Taller-de-diseno-digital-GR01/Proyecto-1-Whack-a-mole/docs/Diseños_Separados/diagrama_lvl_3.md

```mermaid
graph LR
    A--> B

subgraph Circuito DIscreto
    Reloj_555[CLK]
    Numeros_aleatorio[LSF] 

end
```
