Taller-de-diseno-digital-GR01/Proyecto-1-Whack-a-mole/docs/Informe.md

# Informe técnico  — Proyecto 1: Whack-a-mole

EL3313 Taller de Diseño Digital, II Semestre 2026

Grupo 1 - Integrantes:
- Jefferson Chinchilla
- Nicolás Mena
- Mattio Coghi
- Carlos Castro

## 1. Fundamentos Teóricos (Investigación previa)

Esta sección desarrolla los doce temas de investigación previa exigidos por el enunciado del
proyecto, conectando cada concepto con la parte del diseño de este *whack-a-mole* híbrido
(protoboard 74xx + FPGA) donde se aplica dichos conceptos.

### 1.1 Modelado de comportamiento y de estructura en diseño digital

En HDL (Hardware Description Language) existen dos formas complementarias de describir un
circuito. El **modelado estructural** describe el circuito como una interconexión de componentes
más simples ya definidos (instancias de módulos, compuertas), de forma análoga a un esquemático:
se declara *qué* bloques existen y *cómo* se conectan sus puertos, pero no *cómo* calculan su
salida. El **modelado de comportamiento** (o *behavioral*), en cambio, describe la función que debe
cumplir el bloque en términos de su comportamiento observable ante los estímulos de entrada —
asignaciones dentro de bloques `always`/`always_comb`/`always_ff`, expresiones aritméticas y
lógicas, sentencias condicionales — dejando que la herramienta de síntesis infiera la red de
compuertas y biestables que lo implementa.

En este proyecto ambos estilos conviven. `top.sv` es predominantemente **estructural**: instancia
y conecta los módulos `fsm`, `time_logic`, `press_btn`, `hit_counter`, `fail_counter`,
`show_mole`, `marcador`, `r_uart` y `state`, sin describir lógica propia más allá del cableado.
Cada uno de esos módulos hijos, en cambio, se describe de forma **conductual**: por ejemplo
`fsm.sv` (`docs/../src/design/fsm.sv`) define el comportamiento de la máquina de estados mediante
un `case` sobre la variable `state` dentro de un `always_comb`, sin indicar explícitamente qué
compuertas resultan de ello. El subsistema discreto en protoboard, por el contrario, solo puede
describirse de forma estructural en el sentido físico: cada 74xx es un componente ya fabricado
cuya interconexión (y no su contenido interno) es lo que el grupo diseña.

### 1.2 Síntesis lógica en ASIC y en FPGA

La síntesis lógica es el proceso automatizado que traduce una descripción en HDL (típicamente a
nivel RTL — *Register Transfer Level*) a una **netlist**: una lista de compuertas y biestables
interconectados que implementa el comportamiento descrito. El flujo pasa por: (1) análisis y
elaboración del HDL, (2) optimización lógica independiente de tecnología (simplificación booleana,
eliminación de lógica redundante), y (3) *technology mapping*, donde esas ecuaciones booleanas se
traducen a los elementos que realmente existen en la tecnología destino.

La diferencia clave entre ambos flujos está en ese último paso. En un **ASIC**, el *mapping* elige
compuertas de una librería de celdas estándar (`AND2`, `NAND3`, `DFF`, etc.) caracterizadas
eléctricamente para un proceso de fabricación específico; el resultado es un layout físico
custom que se manda a fabricar, sin posibilidad de corrección tras la fabricación. En una
**FPGA**, el *mapping* no genera compuertas nuevas: reparte la lógica entre los recursos
programables que el chip ya trae de fábrica (LUTs, biestables, bloques de memoria, DSPs) y genera
además la configuración de las interconexiones programables entre ellos. Por eso el flujo FPGA
agrega dos pasos que el flujo ASIC no tiene de la misma forma: **place & route** (ubicar cada
elemento lógico en una celda física del arreglo y trazar las rutas entre ellas usando la matriz de
conmutación) y la generación de un **bitstream**, el archivo binario que configura las celdas de
memoria SRAM de la FPGA en cada encendido. En este proyecto, ese flujo (síntesis → *place &
route* → *bitstream*) es exactamente el que ejecuta `make bitstream` sobre la tarjeta Basys3
(ver `src/fpga/build_bitstream.tcl`).

### 1.3 Tecnología de FPGAs

Una FPGA (*Field-Programmable Gate Array*) es un circuito integrado cuya función lógica se
configura después de fabricado, en el campo, en vez de quedar fija en el silicio. Su arquitectura
típica es una matriz de **bloques lógicos configurables** (CLB, *Configurable Logic Block*)
embebidos en una red de interconexión programable:

- **LUT (*Look-Up Table*)**: una memoria SRAM pequeña de 2^K bits que implementa cualquier función
  booleana de K entradas simplemente almacenando, en cada dirección, el valor de salida
  correspondiente a esa combinación de entradas. Es el elemento combinacional universal de la
  FPGA — reemplaza a las compuertas individuales de un ASIC.
- **Biestables (flip-flops)**: uno o más por *slice*, disponibles para registrar la salida de la
  LUT y así construir lógica secuencial sin usar recursos combinacionales adicionales.
- **Multiplexores de configuración**: seleccionan, entre varias opciones cableadas físicamente, cuál
  usa el diseño actual (por ejemplo, si la salida de una LUT pasa o no por el biestable).
- **Matriz de conmutación (*switch matrix*) e interconexión programable**: red de buses y
  interruptores configurables que conectan la salida de un CLB con la entrada de otro,
  permitiendo que un mismo arreglo físico implemente topologías de circuito arbitrarias.
- **Bloques dedicados**: bloques de memoria (BRAM), multiplicadores/DSP y buffers de reloj
  globales (BUFG) que aceleran funciones comunes sin gastar LUTs.

Toda esta configuración —el contenido de cada LUT y el estado de cada interruptor de la matriz de
conmutación— se almacena en celdas SRAM que se cargan desde el bitstream en cada encendido; por
eso una FPGA "olvida" su configuración al apagarse y debe reprogramarse, a diferencia de un ASIC.
La Basys3 usada en este proyecto integra una FPGA Xilinx Artix-7, que sigue esta misma
arquitectura de CLBs de dos *slices*, LUTs de 6 entradas y una red de interconexión jerárquica.

### 1.4 Máquinas de estado finito: Moore vs. Mealy

Una máquina de estados finitos (FSM) es un modelo secuencial cuyo comportamiento depende tanto de
las entradas actuales como de un **estado interno**, almacenado en biestables, que resume la
historia relevante de entradas pasadas. En cada flanco de reloj la FSM evalúa una función de
**siguiente estado** a partir del estado actual y las entradas, y produce salidas mediante una
función de **salida**.

La diferencia entre los dos modelos clásicos está exactamente en esa función de salida:

- **Máquina de Moore**: la salida depende **únicamente del estado actual**, `salida = f(estado)`.
  Esto implica que la salida solo puede cambiar en un flanco de reloj (cuando cambia el estado), lo
  que la hace más lenta en reaccionar a un cambio de entrada, pero elimina el riesgo de generar
  glitches combinacionales en la salida y facilita el análisis de tiempos, porque la salida no
  depende de una ruta combinacional que incluya entradas externas.
- **Máquina de Mealy**: la salida depende **del estado actual y de las entradas presentes**,
  `salida = f(estado, entradas)`. Puede reaccionar en el mismo ciclo en que cambia una entrada
  (una transición completa antes), lo que en general produce máquinas con menos estados para el
  mismo comportamiento, pero la salida puede generar glitches si la entrada cambia de forma
  asíncrona respecto al resto del sistema.

La FSM central de este proyecto (`fsm.sv`) es de tipo **Moore**: dentro del bloque
`always_comb`, todas las señales de salida (`en_numRandom`, `en_save_pos`, `add_hit`,
`add_failure`, `rst_window`, `f_state_play`, `f_state_gameover`, etc.) se asignan según un `case
(state)` que solo examina la variable de estado, nunca directamente las entradas `valid_pos`,
`hit` o `window_exp` dentro de la misma rama de asignación de salida — esas entradas solo se usan
para decidir `next_state`. Esto es deliberado: como la salida `en_numRandom` habilita al
subsistema discreto y las salidas de conteo (`add_hit`, `add_failure`) alimentan contadores
síncronos, se prefiere que permanezcan estables durante todo un estado y cambien solo en los
flancos de reloj, evitando pulsos espurios de habilitación si `hit` o `miss` tuvieran un glitch
combinacional aguas arriba.

**Diagrama de estados (Moore) — señales de salida asociadas a cada estado, no a las transiciones:**

```mermaid
stateDiagram-v2
    [*] --> START
    START --> REQ_POS: rst_dificulty/rst_hits/rst_failures/rst_window = 1
    REQ_POS --> WAIT_UART: en_numRandom = 1
    WAIT_UART --> PLAY: valid_pos (en_numRandom, en_save_pos = 1)
    PLAY --> HIT: hit (f_state_play = 1)
    PLAY --> FAILURE: miss OR window_exp (f_state_play = 1)
    HIT --> REQ_POS: add_hit, inc_dificulty, rst_window = 1
    FAILURE --> REQ_POS: !cont_failure (add_failure, rst_window = 1)
    FAILURE --> GAME_OVER: cont_failure (add_failure, rst_window = 1)
    GAME_OVER --> START: fin_espera (f_state_gameover = 1)
```

Nótese que, en la notación Moore estándar, las etiquetas sobre las flechas son solo condiciones de
transición (entradas), mientras que las salidas —escritas aquí entre paréntesis junto a cada
estado— pertenecen al estado en sí y se mantienen fijas mientras la FSM permanece en él. En una
FSM de Mealy equivalente, salidas como `add_hit` aparecerían directamente sobre la transición
`PLAY → HIT`, es decir, se activarían en el mismo ciclo en que `hit` se vuelve verdadera en vez de
esperar al estado siguiente.

### 1.5 Tiempo de *setup* y tiempo de *hold*

Todo biestable disparado por flanco tiene una ventana de tiempo alrededor del flanco de reloj
activo durante la cual su entrada de datos `D` debe permanecer **estable** para garantizar que la
salida `Q` capture correctamente el valor:

- **Tiempo de *setup* ($t_{su}$)**: intervalo mínimo que `D` debe mantenerse estable **antes** del
  flanco de reloj.
- **Tiempo de *hold* ($t_h$)**: intervalo mínimo que `D` debe mantenerse estable **después** del
  flanco de reloj.

Si alguno de los dos se viola, la salida del biestable puede entrar en un estado **metaestable**:
un nivel de tensión intermedio, indefinido lógicamente, que eventualmente colapsa hacia `0` o `1`
de forma impredecible y en un tiempo variable, en vez de asentarse de inmediato en el valor
esperado. Estas cotas son las que acotan, en un diseño síncrono, cuánto puede demorar la lógica
combinacional entre dos biestables (violación de *setup*, "camino largo") y cuánto puede demorar
como mínimo (violación de *hold*, "camino corto"). Por eso son centrales para el diseño digital:
determinan la frecuencia máxima de operación confiable de un circuito síncrono y, en el caso del
*hold*, incluso pueden causar fallas independientes de la frecuencia de reloj, ya que un camino
demasiado corto entre dos registros viola *hold* sin importar qué tan lento se reloje el sistema.
En este proyecto, estas cotas las garantiza automáticamente la herramienta de *place & route* de
la FPGA (análisis estático de tiempos) para toda la lógica interna a 100 MHz; el diseño del
subsistema discreto en protoboard, en cambio, no cuenta con esa verificación automática, por lo
que las frecuencias de trabajo (9600 baudios) se eligen con margen suficiente para que estas
restricciones nunca se acerquen a ser críticas.

### 1.6 Tiempos de propagación y de contaminación, ruta crítica

En un bloque combinacional, la salida no cambia instantáneamente cuando cambia la entrada:

- **Tiempo de propagación ($t_{pd}$)**: el tiempo **máximo** que tarda la salida en alcanzar su
  valor final y estable tras un cambio en la entrada.
- **Tiempo de contaminación ($t_{cd}$)**: el tiempo **mínimo** que la salida tarda en empezar a
  cambiar (dejar de ser válida) tras un cambio en la entrada.

Entre dos biestables consecutivos, unidos por lógica combinacional, estos tiempos se combinan con
$t_{su}$ y $t_h$ del biestable destino para dar las dos condiciones que el diseño debe cumplir:

$$T_{clk} \geq t_{pcq} + t_{pd} + t_{su} \qquad\qquad t_{ccq} + t_{cd} \geq t_h$$

donde $t_{pcq}$/$t_{ccq}$ son los tiempos de propagación/contaminación del propio flip-flop
origen (reloj → Q). La primera desigualdad es la que impone un límite superior a la frecuencia de
reloj: define la **ruta crítica**, el camino combinacional de mayor $t_{pd}$ entre cualquier par
de registros del diseño, y de ahí la **frecuencia máxima de operación**:

$$f_{max} = \frac{1}{t_{pcq} + t_{pd,\text{ruta crítica}} + t_{su}}$$

En sistemas complejos, la ruta crítica no siempre es obvia a priori: puede atravesar varios
niveles de lógica y varios módulos, por lo que las herramientas de síntesis/implementación la
identifican automáticamente mediante análisis estático de tiempos (STA) y reportan el *slack*
(margen) de cada camino. Un diseño con muchos niveles de lógica combinacional entre registros —por
ejemplo, una cadena larga de comparadores o sumadores sin registrar— alarga la ruta crítica y baja
$f_{max}$; segmentar esa lógica con registros intermedios (*pipelining*) es la técnica estándar
para subir la frecuencia máxima a costa de más latencia en ciclos.

### 1.7 Asignación de relojes y entradas habilitadoras (*clock enables*)

El enunciado exige que todo el subsistema FPGA opere con un único reloj de entrada de 100 MHz, pero
distintas partes del sistema deben avanzar a ritmos muy diferentes: la lógica de juego reacciona a
pulsadores en microsegundos, mientras que la ventana de tiempo se cuenta en cientos de milisegundos
y el marcador se refresca a un ritmo perceptible para el ojo humano. La mala práctica para resolver
esto sería generar relojes derivados con divisores libres (contadores cuya salida se usa como reloj
de otro bloque): eso crea dominios de reloj adicionales dentro de la misma FPGA, con todos los
problemas de *skew*, enrutamiento no dedicado y cruce de dominios de reloj (CDC) que ello implica,
además de que la herramienta de síntesis ya no puede cerrar el análisis de tiempos de forma directa
sobre esa señal.

La alternativa recomendada, y la que usa este proyecto, es mantener un **único reloj físico** de
100 MHz para todos los biestables del diseño, y generar en su lugar señales de **clock enable**:
una señal que vale `1` solo durante el ciclo de reloj en que un bloque debe actualizar su estado, y
`0` en el resto, de modo que ese biestable ignore los demás flancos. `time_logic.sv` implementa
exactamente este patrón: un prescalador (`contador_presc`) cuenta ciclos de 100 MHz hasta alcanzar
`N_PRESC` (el equivalente a 100 ms) y en ese ciclo genera un pulso `tick` de un ciclo de duración;
`ventana_ticks` y `contador_ventana` solo se actualizan cuando `tick` vale `1`
(`else if (tick & (contador_ventana != 0)) contador_ventana <= contador_ventana - 1;`), pese a que
sus biestables siguen disparados por el mismo `posedge clk` de 100 MHz que el resto del sistema.
De esta forma toda la FPGA comparte una sola red de reloj (más fácil de cerrar en tiempos y sin
riesgo de metaestabilidad interna), mientras cada bloque avanza a la cadencia que necesita mediante
su propio `enable`.

### 1.8 Rebotes, ruido y metaestabilidad; sincronizador de dos etapas

**Rebotes (*bounce*).** Un pulsador o interruptor mecánico no transiciona limpiamente entre niveles
al presionarse o soltarse: el contacto metálico rebota físicamente varias veces antes de asentarse,
produciendo una ráfaga de transiciones rápidas (típicamente de algunos a varios milisegundos de
duración) donde un sistema digital, muestreando a alta frecuencia, vería múltiples flancos en vez
de uno solo. Las técnicas para cancelarlo se dividen en:

- **Analógicas**: un filtro RC pasabajos en la línea del pulsador, a veces combinado con un
  disparador Schmitt para restaurar flancos limpios, que atenúa las transiciones rápidas del rebote
  dejando pasar solo el cambio de nivel sostenido.
- **Digitales**: un contador o temporizador que solo acepta el nuevo nivel como válido si se
  mantiene estable durante una ventana de tiempo mínima (por ejemplo, unos pocos milisegundos),
  descartando cualquier transición anterior a ese plazo. Es el enfoque de `debounce.sv` en este
  proyecto: un contador de `N=21` bits solo actualiza la salida `db_out` cuando el propio contador
  alcanza su valor máximo (`q_reg[N-1]`) sin que la entrada haya cambiado de estado en el ínterin
  (`q_reset = dff1 ^ dff2` reinicia el contador ante cualquier cambio).

**Metaestabilidad y entradas asíncronas.** Los ocho pulsadores externos y el botón de reinicio son
señales generadas por el jugador, sin ninguna relación de fase con el reloj de 100 MHz de la FPGA:
son **entradas asíncronas**. Si una de estas señales cambia justo dentro de la ventana de *setup*/
*hold* de un biestable interno, ese biestable puede entrar en metaestabilidad (ver §1.5) y, peor
aún, esa salida indefinida puede propagarse de forma distinta a distintos bloques que la consumen
en el mismo ciclo, produciendo inconsistencias internas.

La solución estándar es el **sincronizador de dos etapas** (*double flip-flop synchronizer*): dos
biestables en cascada, ambos gobernados por el reloj del dominio destino, donde solo la salida del
segundo se considera válida para el resto del sistema. El primer biestable es el que puede volverse
metaestable, pero dispone de un ciclo de reloj completo para resolverse hacia `0` o `1` antes de que
el segundo lo muestree; la probabilidad de que la metaestabilidad sobreviva ambas etapas
decrece exponencialmente con el tiempo disponible y se vuelve despreciable para propósitos
prácticos. El costo es una latencia de dos ciclos de reloj entre el cambio real de la entrada y su
valor sincronizado. `debounce.sv` integra esta técnica directamente: `dff1`/`dff2` son exactamente
ese sincronizador de dos etapas (`dff1 <= btn_in; dff2 <= dff1;`), aplicado *antes* de la lógica de
filtrado de rebotes, de modo que un mismo módulo resuelve ambos problemas —asincronía mecánica y
metaestabilidad eléctrica— para cada uno de los ocho pulsadores.

### 1.9 Registro de desplazamiento discreto (serie-paralelo / paralelo-serie)

Un registro de desplazamiento (*shift register*) es una cadena de biestables tipo D conectados en
cascada, donde la salida de cada etapa alimenta la entrada de dato de la siguiente, y todos
comparten la misma línea de reloj. En cada flanco activo, el contenido completo se desplaza una
posición. Con integrados discretos de la familia 74xx existen dos variantes según cómo se accede al
contenido:

- **Serie-a-paralelo (S/P)**: los bits entran uno a uno por una sola línea de dato serie (`SER`), y
  tras N flancos de reloj las N salidas paralelas (`Q0`...`QN-1`) contienen la palabra completa
  recibida. Es la función que necesita un **receptor** serie: reconstruir un dato paralelo a partir
  de bits que llegan uno por uno.
- **Paralelo-a-serie (P/S)**: el registro admite, además del desplazamiento, una **carga paralela**
  síncrona que copia de golpe un valor de N bits (por ejemplo, `74LS165`) a las N etapas; luego,
  conmutando a modo desplazamiento, esos N bits salen uno a uno por una única línea serie en
  flancos de reloj sucesivos. Es la función que necesita un **transmisor** serie: convertir un dato
  ya disponible en paralelo en un flujo de bits secuencial.

En comunicación serial discreta, ambas modalidades trabajan en conjunto en los dos extremos del
enlace: el lado que transmite usa un registro P/S para empaquetar el dato paralelo en una trama
serie, y el lado que recibe usa un registro (o su equivalente descrito en HDL, como en `r_uart.sv`
de este proyecto) para recomponer esos bits seriales en una palabra paralela. El subsistema
discreto de este proyecto usa esta idea en `docs/Diseño.md` (nivel 4, M5): un registro tipo P/S
que carga la posición generada por el LFSR (§1.10) y la desplaza bit a bit hacia la FPGA siguiendo
el reloj de baudios generado por el 555 (M1).

### 1.10 Generación de números pseudoaleatorios con LFSR

Un **LFSR** (*Linear Feedback Shift Register*) es un registro de desplazamiento cuya entrada serie
no viene de una fuente externa, sino de una función XOR (lineal, sobre GF(2)) aplicada a un
subconjunto fijo de sus propias etapas, llamado los *taps*. En cada flanco de reloj el registro se
desplaza y la nueva etapa de entrada toma el valor de esa combinación XOR, de modo que el registro
recorre una secuencia determinista de estados que, sin conocer la estructura de realimentación,
resulta indistinguible de una secuencia aleatoria — de ahí "pseudo"-aleatorio.

**Polinomio de realimentación y período máximo.** Los *taps* se representan formalmente como un
polinomio sobre GF(2), $p(x) = x^n + c_{n-1}x^{n-1} + \dots + c_1 x + 1$, donde cada coeficiente
$c_i=1$ indica que la etapa $i$ participa en la realimentación. Un registro de $n$ etapas tiene
$2^n$ estados posibles, pero el estado *todo ceros* es un punto fijo (la XOR de puros ceros es
cero, así que el registro nunca sale de ahí), por lo que el período máximo alcanzable es
$2^n - 1$. Ese máximo solo se logra si $p(x)$ es un **polinomio primitivo** sobre GF(2); en ese
caso el LFSR se llama de **longitud máxima** y recorre los $2^n-1$ estados no nulos exactamente una
vez antes de repetirse. Para $n=4$, un polinomio primitivo conocido es
$p(x) = x^4 + x + 1$ (taps en las etapas 4 y 1), que da período $2^4-1=15$; el LFSR de este
proyecto usa en cambio los taps en las etapas 3 y 4 ($D_1 = Q_3 \oplus Q_4$, documentado en
`docs/Diseño.md` nivel 4, M3), que corresponde al polinomio equivalente $x^4+x^3+1$, también
primitivo, y produce igualmente el período máximo de 15 estados — verificado de forma explícita en
la tabla de secuencia de ese documento.

**LFSR discreto vs. descrito en HDL.** Con integrados discretos (74LS74 + 74LS86 en este proyecto),
el LFSR es literalmente lo que su nombre indica: una cadena física de flip-flops con una compuerta
XOR de realimentación cableada; los *taps* quedan fijados por el cableado y modificarlos exige
recablear el circuito. Descrito en HDL para una FPGA, el mismo comportamiento se reduce a una
asignación de un par de líneas de código (por ejemplo `lfsr <= {lfsr[2:0], lfsr[3]^lfsr[2]};`), sin
costo de componentes adicionales, y los *taps* se cambian editando una constante y volviendo a
sintetizar — con la ventaja adicional de que la longitud del registro (y por tanto el rango de
valores generados) es trivial de ajustar en HDL, mientras que en discreto implica agregar o quitar
flip-flops físicos.

### 1.11 Decodificador y su uso para seleccionar 1 de N líneas

Un decodificador de $k$ a $2^k$ líneas toma una palabra binaria de $k$ bits y activa exactamente
**una** de sus $2^k$ salidas — la que corresponde numéricamente al valor de esa palabra — dejando
todas las demás inactivas. El **74LS138** es el ejemplo estándar de 3 a 8 líneas: sus salidas
`Y0`...`Y7` son activas en bajo, y cuenta además con tres entradas de habilitación (`E1`, `E2`
activas en bajo, `E3` activa en alto) que deben cumplirse simultáneamente para que el decodificador
opere; si no se cumplen, todas las salidas permanecen inactivas (en alto) sin importar el valor de
las entradas de selección. Este comportamiento equivale, en lógica de dos niveles, a implementar
cada salida $Y_i$ como la AND de las variables de entrada en su forma directa o negada según el
valor de $i$ en binario (un minitérmino), lo que hace del decodificador el bloque natural para
convertir cualquier función booleana en suma de minitérminos, o —como en este proyecto— para
activar un único indicador físico a partir de un código binario.

En el subsistema discreto de este proyecto (`docs/Diseño.md`, M4), el 74LS138 recibe directamente
`pos[2:0]` desde el LFSR y activa el LED correspondiente a la posición del topo, con sus tres
entradas de habilitación fijas al estado activo de forma permanente (el bloque debe estar
habilitado en todo momento) y aprovechando la polaridad activa en bajo de sus salidas para que sea
el propio integrado quien absorba la corriente del LED en vez de entregarla.

### 1.12 Protocolo de comunicación serial asíncrona UART

UART (*Universal Asynchronous Receiver/Transmitter*) es un protocolo de comunicación serial punto a
punto sin línea de reloj compartida entre transmisor y receptor. Cada trama tiene el siguiente
formato:

| Campo | Duración | Función |
|---|---|---|
| Bit de inicio (*start bit*) | 1 bit, siempre en `0` | Marca el comienzo de la trama; su flanco de bajada es la única referencia temporal que el receptor usa |
| Bits de datos | típicamente 5–9 bits, LSB primero | Contienen el dato a transmitir |
| Bit de paridad (opcional) | 0 o 1 bit | Detección simple de errores de un bit |
| Bit(s) de parada (*stop bit*) | 1 o 2 bits, siempre en `1` | Devuelve la línea a su nivel de reposo y da margen antes de la siguiente trama |

Entre tramas, la línea permanece en reposo en nivel alto; el flanco de bajada que marca el inicio
del *start bit* es lo único que el receptor necesita detectar para sincronizarse: a partir de ese
instante, cuenta sus propios intervalos de tiempo (derivados de su propio reloj) del tamaño de un
bit, y muestrea la línea en el centro de cada intervalo sucesivo. El **baud rate** es la cantidad de
símbolos (bits) transmitidos por segundo; ambos extremos deben acordarlo de antemano porque no hay
ninguna señal de reloj física compartida que se lo indique al receptor durante la trama.

Que dos dispositivos sin reloj compartido puedan comunicarse de forma confiable depende de que
ese acuerdo previo de velocidad sea preciso: cada dispositivo genera su reloj de bit de forma
completamente local (en este proyecto, un 100 MHz dividido internamente en la FPGA vs. un
oscilador NE555 discreto en el protoboard), y cualquier diferencia entre esas dos frecuencias
nominalmente iguales hace que el punto de muestreo del receptor se desplace, bit a bit, respecto al
centro real del bit transmitido. Como el receptor solo se resincroniza en cada nuevo *start bit*,
ese desfase se acumula a lo largo de toda la trama y es mayor en el bit más alejado del flanco de
sincronización — el bit de parada. La tolerancia de error de reloj admisible se deriva justamente
de exigir que ese desfase acumulado, en el bit más lejano, sea menor a medio período de bit (para
no cruzar hacia el bit vecino); con una trama 8N1 (1 inicio + 8 datos + 1 parada) ese análisis da
un límite teórico de aproximadamente 1/19 ≈ 5,3 % de error relativo entre los dos relojes (deducido
en detalle en `docs/Diseño.md`, nivel 4, M1), consistente con la práctica de la industria de acotar
el error combinado de los dos extremos de un enlace UART típico a 2–3 % para dejar margen de
diseño. Este proyecto fija su velocidad en 9600 baudios —una tasa estándar, fácil de generar con un
555 dentro de esa tolerancia usando resistencias de precisión al 1 %— precisamente para que ese
margen se cumpla sin necesidad de calibración activa entre los dos dominios de reloj.

---

## Referencias

- [Configurable Logic Block — ScienceDirect Topics](https://www.sciencedirect.com/topics/computer-science/configurable-logic-block)
- [Xilinx Artix-7 architecture — CSE UNL](https://cse.unl.edu/~jfalkinburg/cse_courses/2022/436/lecture/lecture32.html)
- [FPGA Clock Design Scheme: Best Practices — DEV Community](https://dev.to/carolineee/fpga-clock-design-scheme-best-practices-and-implementation-guide-3bke)
- [Mastering Clock Management in Xilinx 7 Series FPGAs — Kite Metric](https://kitemetric.com/blogs/mastering-clock-management-in-xilinx-7-series-fpgas)
- [Linear feedback shift register, 4-bit maximal length — UOBabylon](https://www.uobabylon.edu.iq/eprints/paper_1_17528_649.pdf)
- [Maximum Length Linear Feedback Shift Registers — Peter Fischer, Uni Heidelberg](https://sus.ziti.uni-heidelberg.de/Lehre/WS_DST/LFSR.pdf)
- [Determining Clock Accuracy Requirements for UART Communications — Analog Devices](https://www.analog.com/en/resources/technical-articles/determining-clock-accuracy-requirements-for-uart-communications.html)
- [UART Baud Rate: How Accurate Does It Need to Be? — All About Circuits](https://www.allaboutcircuits.com/technical-articles/the-uart-baud-rate-clock-how-accurate-does-it-need-to-be/)
- [Understanding Digital Circuit Timing: Setup Time, Hold Time, Contamination Delay & Clock Skew — JLCPCB](https://jlcpcb.com/blog/digital-circuit-timing-basics)
- [Lesson 12: Setup and Hold Time — Nandland](https://nandland.com/lesson-12-setup-and-hold-time/)
- [Clock Domain Crossing Techniques & Synchronizers — EDN](https://www.edn.com/synchronizer-techniques-for-multi-clock-domain-socs-fpgas/)

## 2. Presentación de resultados

Todos los módulos SystemVerilog del subsistema FPGA tienen su propio testbench en `src/sim/`,
verificado con `make sim TB=<módulo>` o corriendo el paquete completo con `make test`. Las formas
de onda que acompañan cada módulo se generaron con `make dump TB=<módulo> SIGS=señal1,señal2,...`,
que corre la simulación y exporta un SVG con `vecdump`, una herramienta hecha aparte para este
propósito que lee el `.vcd` producido por `iverilog`/`vvp` y dibuja el diagrama de tiempo
directamente en SVG, sin pasar por una captura de pantalla de GTKWave. El código fuente y los
testbenches completos de cada módulo pueden revisarse en `src/design/` y `src/sim/` respectivamente.

Antes de poder generar estas capturas hubo que corregir varios testbenches que habían quedado
desactualizados respecto a la interfaz actual de los módulos que prueban. El detalle de esos
arreglos, y de las discrepancias reales que sí quedaron pendientes de resolver en el diseño, se
discute en la sección 3.

### 2.1 M1 y M1b, receptor y transmisor UART (`r_uart.sv`, `t_uart.sv`)

`r_uart.sv` recibe una trama serial 8N1 y la traduce a `pos_topo`/`valid_pos`. Su testbench
(`tb_r_uart.sv`) cubre cuatro casos, una trama válida con dato `8'h05`, una trama válida con dato
`8'hFA` (para confirmar que solo los 3 bits bajos se usan como posición), una trama con *stop bit*
inválido (debe descartarse sin activar `valid_pos`), y una trama válida pero con `en_save_pos=0`
(no debe capturar). Los cuatro casos pasan.

Recepción UART, trama válida y trama descartada por stop bit inválido

`t_uart.sv` es el transmisor interno agregado para el enlace en *loopback* (reemplaza al
transmisor discreto, no confiable, para efectos de simular todo el sistema dentro de la FPGA). Su
testbench arma tres tramas (posiciones 5, 2 y 7) y muestrea `tx` en el centro de cada bit para
verificar el formato completo (inicio, 8 datos LSB primero, parada). Los 32 checks (reposo inicial
más 3 tramas de unos 10 bits cada una) pasan.

Transmisión UART interna, tramas para las posiciones 5, 2 y 7

### 2.2 M2, despliegue del topo (`show_mole.sv`)

Módulo puramente combinacional, activa uno de los 8 LEDs según `pos_topo` mientras `en_topo` esté
en alto, y los apaga todos si `en_topo=0`. Su testbench (`tb_show_mole.sv`) no hace *self-checking*
(sigue la convención del equipo de revisar la forma de onda a ojo para módulos puramente
combinacionales), así que no hay PASS/FAIL que reportar, solo la forma de onda para inspección
visual.

Recorrido de las 8 posiciones con en_topo en 0 y en 1

### 2.3 M3, botones (`press_btn.sv`, formado por `debounce` + `encoder_8_to_1` + `check_btn`)

El testbench (`tb_press_btn.sv`) presiona y mantiene un botón, verificando que `valid` se active
exactamente cuando el botón sostenido corresponde a `pos_topo`. Cuatro casos, botón correcto, botón
incorrecto, ningún botón presionado, botón correcto en otra posición. Los cuatro pasan.

Pulso de valid sincronizado con el botón correcto tras el debounce

### 2.4 M4, lógica de tiempo (`time_logic.sv`)

El testbench reduce los parámetros de reloj y ventana a valores pequeños para simular rápido
(`CLK_FREQ_TB=1000`, ventana inicial equivalente a 3 ticks, piso de 1 tick) y verifica, inspeccionando
`ventana_ticks`/`contador_ventana` con `$display`, que sin ningún acierto la ventana expira y activa
`UP`, que cada acierto baja `ventana_ticks` en 1, y que un tercer acierto seguido, ya en el piso, no
lo baja más allá del mínimo.

Ventana de tiempo bajando con cada acierto hasta tocar el piso

### 2.5 M5, contador de aciertos (`hit_counter.sv`)

Verifica el acarreo BCD (unidades a decenas en el décimo acierto), la saturación en 99, y que un
`nueva_partida` o `rst` simultáneo con un `hit` gane sobre el incremento.

Conteo BCD de aciertos, acarreo en el hit 10 y saturación en 99

### 2.6 M6, contador de fallos (`fail_counter.sv`)

Misma lógica de acumulado BCD que M5 pero con `miss`, más la racha de fallos consecutivos
(`consecutivos`) y la bandera `fin_partida` que se activa al tercer fallo seguido. El testbench
confirma que un `hit` intercalado rompe la racha sin bajar el acumulado de `fallo`, y que
`nueva_partida`/`rst` limpian todo incluyendo `fin_partida`.

Racha de fallos consecutivos activando fin_partida, y un hit rompiéndola

### 2.7 M7, estado de juego (`state.sv`)

Cubre los cuatro estados de `(f_state_play, f_state_gameover)`, reposo, partida activa (LED fijo),
combinación inválida (apagado seguro) y fin de partida (parpadeo más `fin_espera` a los 2s reales,
acelerado en el testbench con `N_PRESC=10`). De 13 verificaciones puntuales, 1 falla, el pulso de
`fin_espera` llega un tick de 100ms más tarde de lo que el testbench asume. La causa se discute en
la sección 3, es un hallazgo nuevo porque este testbench no compilaba antes de esta sesión.

Entrada a fin de partida, parpadeo del LED y pulso de fin_espera

### 2.8 M8, máquina de estados central (`fsm.sv`)

Recorre los siete estados (`START, REQ_POS, WAIT_UART, PLAY, FAILURE, HIT, GAME_OVER`), camino
feliz hasta un acierto, un fallo por botón incorrecto, expiración de ventana, prioridad de `hit`
sobre `miss` simultáneos, la racha hasta `GAME_OVER` y el regreso a `START` vía `fin_espera`, y el
reset. Los 9 checks pasan.

Transiciones de la FSM, camino feliz, fallo, y GAME_OVER hasta START

### 2.9 Integración (`top.sv`)

`tb_top.sv` conecta todos los módulos anteriores (incluyendo `r_uart`/`t_uart` en *loopback*
interno, ya que el transmisor discreto real no es confiable) y corre 5 escenarios de principio a
fin, acierto normal, fallo por botón equivocado, tres fallos consecutivos hasta `GAME_OVER` y
reinicio automático, expiración de ventana sin presionar nada, y el multiplexado de los 4 dígitos
del marcador. Las 12 verificaciones pasan, después de corregir el parámetro de time_logic.sv que
se describe en la sección 3 (antes de esa corrección, 3 de las 12 fallaban, las tres por la misma
causa raíz).

Escenario de integración completo, acierto, fallos consecutivos y GAME_OVER

## 3. Análisis e interpretación de resultados

### 3.1 Corrección de la infraestructura de verificación (prerrequisito, no hallazgo de diseño)

Antes de interpretar cualquier resultado hay que poder confiar en la herramienta que lo produce.
Esta sección documenta trabajo de mantenimiento sobre los testbenches en sí, no una observación
sobre el comportamiento del diseño, y por eso se separa de los hallazgos reales de las secciones
3.2 a 3.4.

Antes de poder correr `make test` sin errores de compilación hubo que corregir varios testbenches
que habían quedado detrás de cambios de interfaz en los módulos que prueban, probablemente de
revisiones que ampliaron los puertos de `fsm.sv` y separaron el reset único de `time_logic.sv` en
`rst_dificulty`/`rst_window`, sin que ese cambio se propagara a todos los testbenches ya existentes:

- `tb_show_mole.sv` instanciaba un módulo `m02_show_mole` que no existe (el módulo real se llama
  `show_mole`), no compilaba en absoluto.
- `tb_state.sv` instanciaba `estado_juego`, que tampoco existe (el módulo real se llama `state`),
  tampoco compilaba.
- `tb_time_logic.sv` conectaba un puerto `rst` que ya no existe en `time_logic.sv` (ahora son dos
  puertos separados, `rst_dificulty` y `rst_window`), no compilaba.
- `tb_fsm.sv` usaba conexión implícita (`fsm dut(.*)`) y le faltaba declarar la señal
  `fin_espera`, que la FSM ahora recibe como entrada, tampoco compilaba.
- `press_btn_tb.sv` no seguía la convención de nombres `tb_*.sv`, así que el Makefile ni siquiera lo
  detectaba como testbench disponible, no aparecía en `make list`.
- Una vez corregidos los tres primeros puntos, `press_btn_tb.sv` (ya renombrado a
  `tb_press_btn.sv`) sí compilaba y corría, pero fallaba 2 de 4 casos porque el reset se activa
  (`rst=1`) para el pulso inicial y nunca se vuelve a desactivar, así que el módulo bajo prueba
  queda en reset permanente. Al corregir eso hizo falta además actualizar cómo se verifica `valid`,
  porque el diseño actual la genera como un pulso de un solo ciclo (commit "evita miss fantasma
  tras un hit") y el testbench todavía la muestreaba como si fuera una señal de nivel, tomando su
  valor recién al final de la ventana de espera, momento en el que el pulso ya había pasado.
- `tb_fsm.sv` probaba el reset de la FSM como si fuera asíncrono (`rst=1; #1;` sin esperar el
  flanco de reloj), pero `fsm.sv` lo tiene síncrono desde el commit "trae de develop el fix de
  fsm.sv (en_numRandom sostenido + reset sincrono)".
- `tb_r_uart.sv` y `tb_t_uart.sv` escribían su volcado a `dump.vcd` en vez de
  `tb_r_uart.vcd`/`tb_t_uart.vcd`, y `tb_state.sv` a `estado_juego.vcd` en vez de `tb_state.vcd`,
  así que `make dump` (que asume el nombre `tb_<módulo>.vcd`) no los encontraba.

Ninguno de estos cambios tocó `src/design/`, son correcciones del lado del testbench para que
reflejaran la interfaz y el comportamiento actuales del diseño.

### 3.2 Hallazgo real, corregido, la ventana inicial de time_logic.sv no correspondía a 1.5 s

Los tres fallos que originalmente tenía `tb_top.sv` (la dificultad que no bajaba de 15 a 14 tras un
acierto, la dificultad que no volvía a 15 en la partida nueva, y la ventana que no expiraba dentro
del margen esperado) tenían la misma causa raíz, confirmada instrumentando la simulación con
`$display` adicionales, el parámetro por defecto `VENTANA_INICIAL` en `time_logic.sv` valía `5000`,
no `1500`.

Con `TICK=100` (ms), eso daba `VENTANA_TICKS_INICIAL = VENTANA_INICIAL/TICK = 50` ticks, no los 15
que tanto el testbench de integración como el enunciado (sección 3.3, "la ventana de tiempo de
vuelta a su valor inicial de 1,5 s") esperan. La lógica de decremento en sí funcionaba bien, se
confirmó que `ventana_ticks` sí bajaba de 50 a 49 tras un acierto, exactamente 1 tick como debe ser,
el problema era únicamente que el punto de partida no era el que pide el enunciado. Eso también
explicaba el tercer fallo, con `VENTANA_TICKS_INICIAL=50` la ventana tardaba unos 50000 ciclos en
expirar bajo los parámetros acelerados de `tb_top.sv`, pero el caso 4 solo esperaba 25000 ciclos
antes de darse por vencido, así que el timeout del testbench, escrito asumiendo 15 ticks, se agotaba
antes de que la ventana real (50 ticks) terminara de expirar.

Se corrigió cambiando `VENTANA_INICIAL = 5000` por `VENTANA_INICIAL = 1500` en `time_logic.sv`. Con
ese único cambio los tres casos de `tb_top.sv` pasan sin ningún otro ajuste, porque ya estaban
escritos asumiendo el valor correcto según el enunciado.

### 3.3 Hallazgo real, corregido, la tasa de parpadeo del LED en state.sv no coincidía con su propio comentario

`state.sv` documenta en su propio código el parpadeo del LED de fin de partida como "conmuta cada
2 habilitaciones de 100ms (periodo de 400ms, 2.5 Hz)", pero el `always_ff` de `blink_toggle`
conmutaba en cada tick de 100ms, no cada dos, lo que daba un período real de 200ms (5 Hz), el doble
de rápido que lo documentado. `tb_state.sv` fue escrito asumiendo el comportamiento documentado
(dividir entre 2), y por eso sus dos primeros checks de parpadeo fallaban al medir el LED justo
donde el diseño real ya había alcanzado a conmutar dos veces en vez de una.

El enunciado no exige una frecuencia de parpadeo específica, solo que el LED de fin de partida sea
"claramente distinguible" del LED fijo de partida activa, así que esto no era una violación de la
especificación como el punto anterior, era una inconsistencia entre lo que el módulo decía que hacía
y lo que realmente hacía. Se corrigió agregando un divisor entre 2 al conteo de ticks
(`blink_div`), para que `blink_toggle` conmute cada 2 ticks tal como dice el comentario original del
módulo.

### 3.4 Hallazgo real, documentado sin corregir, fin_espera llega un tick tarde

Al arreglar el punto anterior siguió fallando un segundo check independiente de `tb_state.sv`, el
pulso de `fin_espera` en el tick 20. Instrumentando la simulación se confirmó que la causa es
distinta a la del parpadeo, en el mismo ciclo en que `wait_cnt` llega a `WAIT_COUNT` (su meta), el
prescalador `presc_cnt` también se reinicia a 0 porque ambos comparten la misma condición de tick.
Eso hace que `tick_100ms` ya esté en 0 justo cuando `wait_done` se vuelve 1, así que la expresión
combinacional `fin_espera = tick_100ms && wait_done` no puede ser verdadera en ese instante exacto.
El pulso real sí llega, pero un tick de 100ms completo después, en la siguiente vez que
`presc_cnt` vuelve a tocar su máximo, momento en el que `wait_done` ya se mantiene en 1 y sí
coincide con `tick_100ms`.

En la práctica esto no rompe el juego, la FSM solo necesita ver `fin_espera` una vez para volver a
`START`, y `tb_top.sv` lo confirma (pasa completo con este comportamiento). Tampoco viola el
enunciado, que pide un mínimo de 2s en fin de partida, un tick de 100ms de más sigue cumpliendo ese
mínimo. Se documenta aquí sin corregir porque no se preguntó por este hallazgo específico, si el
equipo quiere el pulso exacto en el tick 20 en vez de uno más tarde, hay que registrar `fin_espera`
usando el valor de `wait_cnt` justo antes de que se actualice, en vez de compararlo contra
`wait_done` ya actualizado en el mismo ciclo que `tick_100ms` cae a 0.

### 3.5 Síntesis y cobertura de la verificación

En total, de los ocho módulos SystemVerilog con testbench propio más la integración completa
(`tb_top.sv`), se encontraron dos hallazgos reales que sí requerían corregir `src/design/` (3.2 y
3.3) y uno que se documentó sin corregir por no afectar el cumplimiento del enunciado (3.4); el
resto de los fallos iniciales (sección 3.1) eran del lado del testbench, no del diseño.

Toda esta verificación cubre exclusivamente el subsistema FPGA: cada módulo de `src/design/` corre
bajo simulación con `iverilog`/`vvp`, incluyendo `r_uart`/`t_uart` en *loopback* interno (sección
2.9). El subsistema discreto (oscilador NE555, LFSR, decodificador 74LS138 y su acondicionamiento
de línea) no pasa por esta misma verificación automática porque vive fuera del dominio de HDL
simulable; su corrección se sustenta en el análisis analítico del Nivel 4 del diseño
(cálculo de tolerancia de frecuencia entre relojes, tablas de verdad de las compuertas discretas), simulación con la herramienta de multisim y análisis en laboratorio con el analizador lógico.

## 4. Conclusiones y aprendizaje obtenido

De este proyecto se puede concluir lo siguiente:

1. El diseño modular no es algo definitivo, ya que la verificación física (hardware) produjo cambios en el diseño planeado previamente en papel. El caso más claro es el enlace serial: en el diseño se especificó un transmisor UART discreto con 555 y lógica TTL, pero en la implementación se sustituyó por un loopback interno (t_uart.sv) dentro de la FPGA. Esto sugiere que la tolerancia de frecuencia/fase entre dos relojes independientes (protoboard vs. FPGA), aunque calculada en el diseño, resultó poco confiable en la práctica o inviable de validar a tiempo, y se optó por una solución equivalente funcionalmente pero más controlable.

2.  El diseño en papel identificó correctamente los bloques funcionales, pero no todos los casos borde de sincronización. Los bugs corregidos en press_btn (miss "fantasma") y encoder_8_to_1 (validación de botón único) muestran que las tablas de verdad del documento eran correctas en el caso "normal", pero no cubrían condiciones de carrera entre flancos de señales asíncronas (botón sostenido tras un hit, múltiples botones simultáneos). Es una conclusión típica de diseño digital: las tablas de verdad estáticas no siempre capturan el comportamiento temporal real.

3.  La FSM principal (M8) se especificó de forma general en el documento y se completó durante la codificación del diseño. Esto indica que el nivel de detalle "de bloques" del documento fue suficiente para guiar la implementación, pero la FSM final fue modificada directamente en HDL según las necesidades de los otros subsitemas, y no fue una traducción directa de una tabla predefinida. La FSM se debe diseñar de primero, pero quizás dependiendo de las demás implementación debe ser implementada al final.

4.  Fail_counter muestra que no se analizo correctamente la temporización de los datos en algunos módulos, lo cual produjo un impacto funcional real ( en este caso: fallo detectado un ciclo/turno tarde). Es evidencia de que ciertas decisiones de bajo nivel (secuencial vs. combinacional) deberían haberse especificado en el diseño para evitar el bug, o al menos quedar como una decisión de diseño explícita más que implícita en el código.

5. En conjunto, los módulos de datapath puro (UART, contadores BCD, time_logic, show_mole, marcador) se implementaron fielmente al diseño, mientras que los cambios reales se concentraron en las interconexiones de los subsistemas (enlace serial) y en el control (FSM, detección de eventos de botón) — que es justo donde suelen aparecer los problemas de sincronización en diseño digital, no en el datapath aritmético.
