Taller-de-diseno-digital-GR01/Proyecto-1-Whack-a-mole/docs/Diseños_Separados/diagrama_FPGA.png

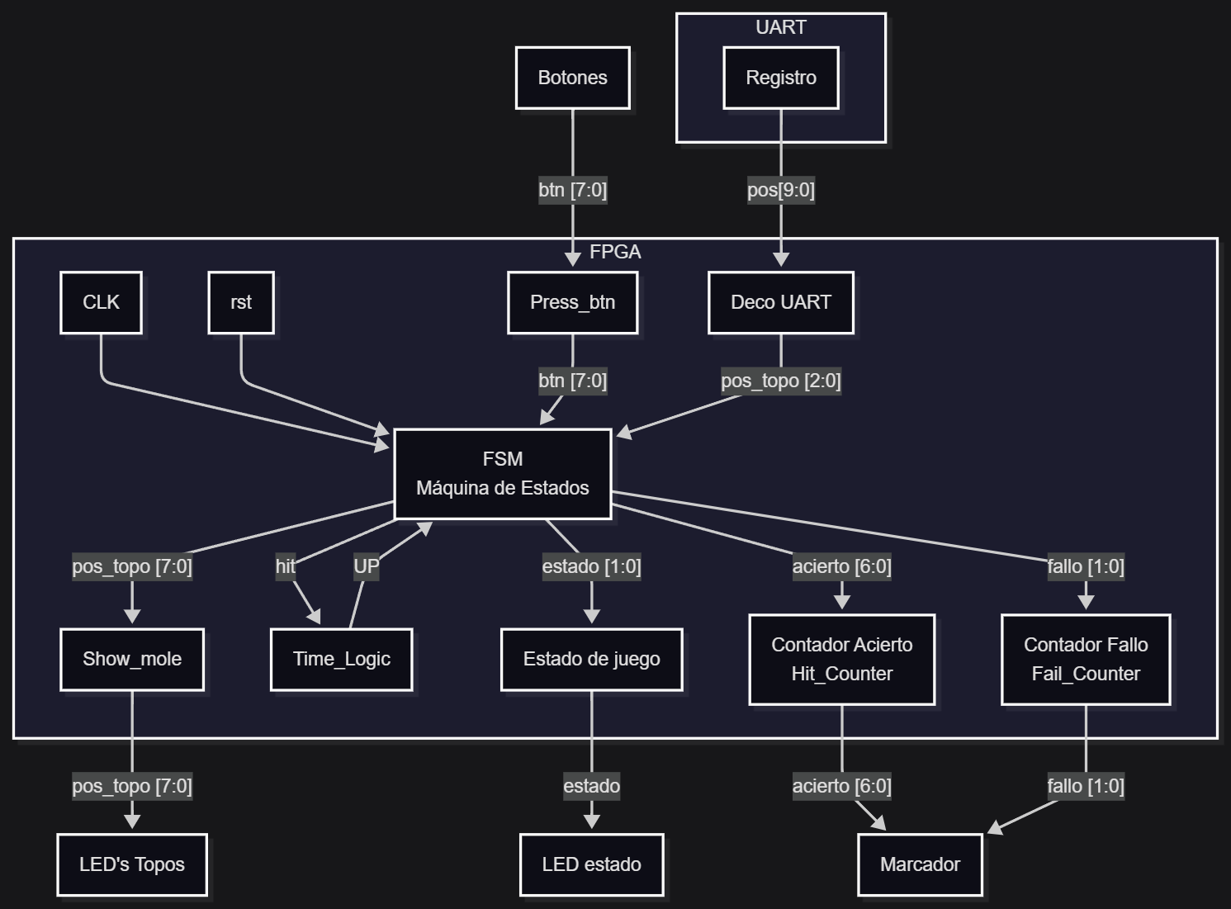
docs/Diseños_Separados/diagrama_FPGA.png
