Taller-de-diseno-digital-GR01/Proyecto-1-Whack-a-mole/docs/Diseños_Separados/img/m5.png

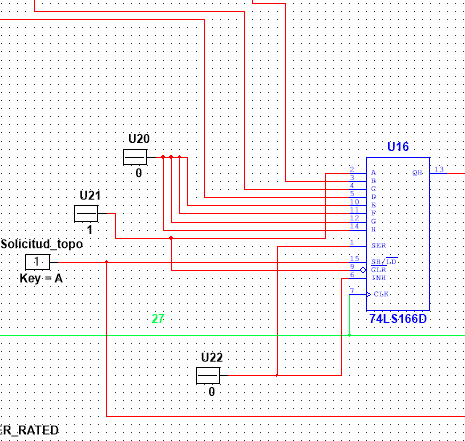
docs/Diseños_Separados/img/m5.png
