Taller-de-diseno-digital-GR01/Proyecto-1-Whack-a-mole/docs/Diseños_Separados/uart_fpga_system.png

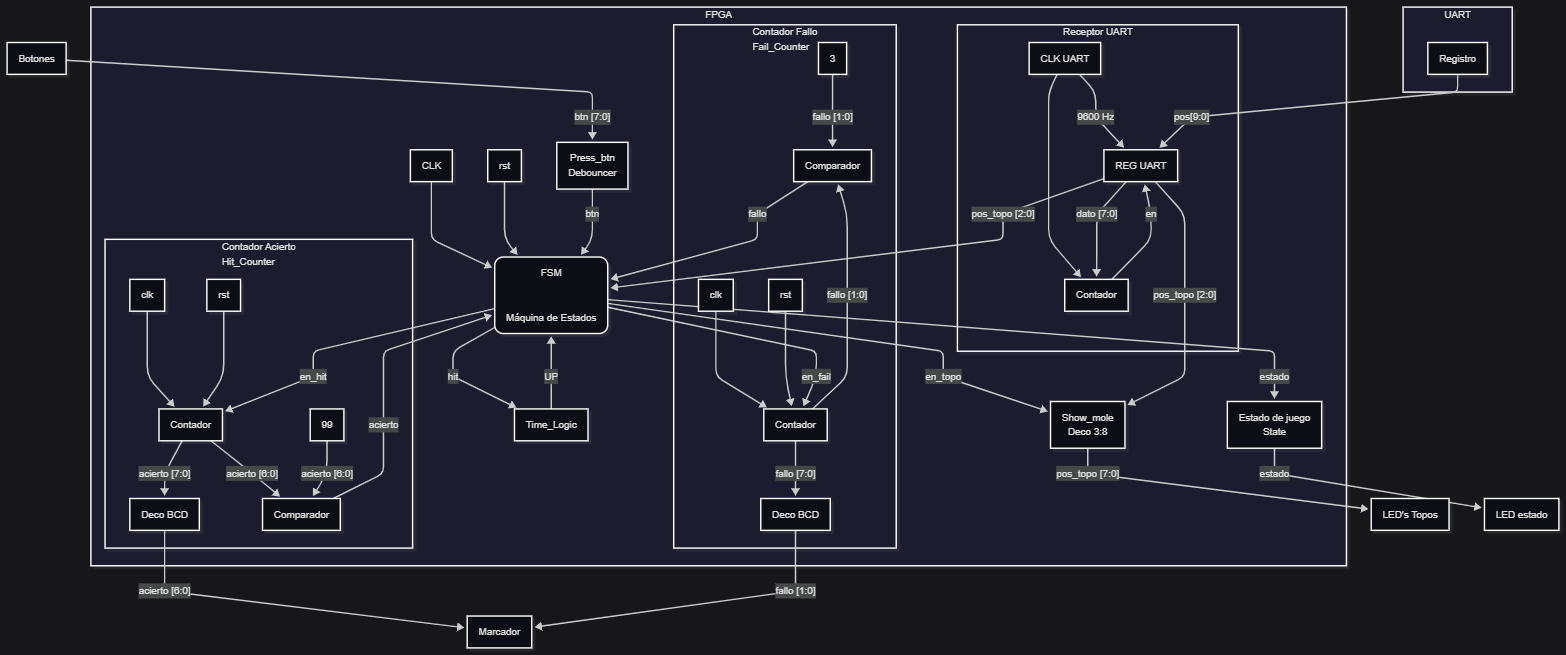
docs/Diseños_Separados/uart_fpga_system.png
