Taller-de-diseno-digital-GR01/Proyecto-1-Whack-a-mole/(list of files, drawings)

Other design files:
discreto/Simulacion_bloque_discreto.ms14
