Taller-de-diseno-digital-GR01/Proyecto-1-Whack-a-mole/(commit log)

2026-08-11 Prototipo de mermaid - Nivel 3
2026-08-12 Actualización de Diagramas
2026-08-13 Realizada la simulacion del bloque discreto para el diseno de cuarto nivel
    [Simulacion_bloque_discreto.ms14]
2026-08-13 Diagrama de Bloques de FPGA - 3er NIvel
2026-08-13 Correciones de Diagrama de FPGA
2026-08-13 Diagrama de cuarto nivel añadido
2026-08-13 Diagrama de Flujo y FSM
2026-08-13 Imagen de la FSM
2026-08-13 Diagrama de cuarto nivel modificado
2026-08-13 Diagrama de cuarto nivel con imagenes
2026-08-13 Diagrama de cuarto nivel con imagenes pt2
2026-08-13 Removido modulo de registo obsoleto
2026-08-13 Primer commit para diagramas lvl 4 fpga
2026-08-13 Nivel 4 para hit_counter añadido
2026-08-13 Nivel 4 para time_logic añadido
2026-08-13 actualización del diagrama de flujo
2026-08-13 Renombramiento de archivos para que tengan numeros
2026-08-13 Añadido el diagrama para el módulo 1
2026-08-13 Tablas de verdad añadidas a 04, 05 & 07
2026-08-14 Correciones de Diagrama y Descripción de de 3er nivel
2026-08-14 Descripción de 3er nivel Final
2026-08-14 Integra el diseño de cuarto nivel del subsistema discreto
    Trae M1-M5 (reloj de baudios con justificación de tolerancia UART,
    control de avance/modo, LFSR, decodificador y acondicionamiento de
    línea) desde diseno_bloque_discreto, para que ambos subsistemas
    (discreto y FPGA) queden documentados a nivel 4 en la misma branch.
2026-08-14 Diagrama de tercer nivel para UART actualizado
2026-08-14 Correccion a modulos de Descripción_3er Nivel.md
2026-08-14 Correcciones a la señal Pos y a el modulo 1 en Descripción_3er Nivel.md
2026-08-14 Correción en M1 de 4to nivel
2026-08-14 Correciones en Receptor UART del diagrama 3er nivel
2026-08-14 Reorganizar estructura de directorios del proyecto
    Mueve la documentación de diseño dispersa en Diagramas/ hacia docs/diseño/
    (con subcarpeta fpga/ para los módulos de nivel 4 y img/ para las imágenes
    compartidas), el esquemático Multisim del subsistema discreto de
    Simulaciones/ a discreto/, y crea el placeholder de docs/informe/ exigido
    por la rúbrica. Elimina archivos de respaldo de draw.io (.bkp/.dtmp), un
    documento vacío y una imagen duplicada sin referenciar, y agrega .gitignore
    para evitar que los autoguardados de draw.io se vuelvan a trackear.
    [Simulacion_bloque_discreto.ms14]
2026-08-14 Corregir rutas de imagen rotas por la reorganización
    diagrama_lvl_4.md quedó al mismo nivel que img/ (antes estaba un nivel
    abajo, en discreto/), así que las referencias ../img/m1.png, ../img/m3.png
    y ../img/m6.png pasan a img/m1.png, img/m3.png e img/m6.png. Ningún otro
    .md tenía rutas relativas afectadas por el movimiento.
2026-08-14 Agregar README.md como índice de navegación de la documentación
    Punto de entrada único con el índice de diseño por niveles (con
    subenlaces por módulo y por lado discreto/FPGA donde el contenido está
    dividido en varios documentos), más las secciones de informe técnico,
    código SystemVerilog, simulaciones y subsistema discreto, el árbol de
    directorios resultante e instrucciones de compilación.
2026-08-14 Carné de Jefferson Agregado
2026-08-14 actualización readme - correción de portada
2026-08-18 Documento de Diseño completo
2026-08-18 Prescalador de 100ms listo.
2026-08-18 Registro para dificultad finalizado
2026-08-18 Variables renombradas para más claridad
2026-08-18 Contador de ventana listo + pequeño refactor
2026-08-19 Testbench para time_logic añadido
2026-08-19 Añadido comentarios de clarificación para testbench
2026-08-19 Primer commit para hit_counter
2026-08-19 Correción del Diseño M01 de 4to nivel
2026-08-19 correcciones de estado de FSM
2026-08-20 Pruebas de tb completas
2026-08-20 Testbench para hit_counter finalizado
2026-08-20 Creado el diseño del modulo y su testbench, pendiente comprobar
2026-08-20 Typos arreglados para directorios
2026-08-20 Makefile para BSD añadido
2026-08-20 Makefile para linux arreglado
2026-08-20 Archivo solo de mermaid movido a docs
2026-08-20 Primer commit para fail_hit
2026-08-20 tb para fail_counter iniciado
2026-08-21 Testbench de fail_counter listo
    [tb_fail_counter.sv, tb_hit_counter.sv, tb_time_logic.sv]
2026-08-21 Corrección de error en Debounce
    [debounce.sv, press_btn.sv]
2026-08-22 Borrado de archivos repetidos
2026-08-22 corrección lógica de check_btn
2026-08-22 Primer commit para marcador
    Claude-Session: https://claude.ai/code/session_01FGcydDy2brLhh6RAVSAHyf
2026-08-23 modificación design+tb de FSM y modulo state
2026-08-23 adaptación FSM-modulos para concordancia de la lógica
2026-08-23 correción de tb + vcd
2026-08-24 modificación de modulos + comentarios
2026-08-24 Primer commit para marcador
2026-08-24 Cambio en GAMEOVER para esperar 2s
2026-08-24 I/O y prescalador de refresco para marcador
2026-08-24 Multiplexado de los 4 dígitos en marcador
2026-08-24 Nombre de Módulo y Archivo corregidos, ahora son iguales
2026-08-24 Comentario añadido para el deco
2026-08-24 Selector de dígito a operador ternario
2026-08-25 error double driver
2026-08-25 Cleanup necesario para .vcd fuera de su respectiva carpeta
2026-08-25 Makefile con synth arreglado
    [check_btn.sv]
2026-08-26 Transmisor UART interno (t_uart) en loopback + fixes en encoder, state y top
    El transmisor UART discreto no es confiable: el LFSR discreto se conecta
    ahora directo a la FPGA por 3 líneas paralelas (pos_topo_lfsr) y un nuevo
    módulo t_uart arma la trama 8N1 internamente, en loopback hacia r_uart.
    De paso: encoder_8_to_1 ya no registra golpe fantasma en pos 0 cuando se
    presionan dos botones a la vez, state.sv sincroniza el prescalador de
    100ms con el inicio de GAME_OVER (evita acortar el mínimo de 2s), y se
    limpia f_state_play (antes red implícita + f_state_state sin usar).
    [basys3.xdc, encoder_8_to_1.sv, state.sv, t_uart.sv, tb_t_uart.sv, tb_top.sv, top.sv]
2026-08-27 trae de develop el fix de fsm.sv (en_numRandom sostenido + reset sincrono)
    [fsm.sv]
2026-08-27 detector de flanco + constraints cambiados
2026-08-27 modificación de valor máximo del fallo
2026-08-27 agrega make connect para diagnosticar USB/JTAG antes de programar
2026-08-27 agrega doas a comandos de USB/JTAG en make connect/program (FreeBSD)
2026-08-27 fail_counter se reinicia solo tras GAME_OVER, no solo con rst manual
    [top.sv]
2026-08-28 press_btn: evita miss fantasma tras un hit (comparar solo en el flanco del boton, no en nivel)
2026-08-28 arreglar testbenches que no compilaban por interfaces desactualizadas
    tb_show_mole.sv y tb_state.sv instanciaban modulos con nombres viejos
    (m02_show_mole, estado_juego) que ya no existen. tb_time_logic.sv
    conectaba un puerto rst que ya no existe en time_logic.sv (ahora son
    rst_dificulty y rst_window separados). tb_fsm.sv usaba conexion
    implicita y le faltaba la señal fin_espera que la fsm ahora recibe
    como entrada, y probaba el reset como asincrono cuando fsm.sv lo tiene
    sincrono desde hace un par de commits.
    [tb_fsm.sv, tb_press_btn.sv, tb_show_mole.sv, tb_state.sv, tb_time_logic.sv]
2026-08-28 tb_press_btn.sv: el reset se quedaba pegado y valid se muestreaba mal
    rst se ponia en 1 para el pulso de reset inicial pero nunca se volvia
    a bajar, asi que el debounce quedaba en reset permanente durante toda
    la simulacion y los botones nunca generaban valid. De paso, valid ya
    es un pulso de un ciclo (por el fix de evita miss fantasma) y el
    testbench todavia lo muestreaba como señal de nivel al final de la
    ventana de espera, cuando el pulso ya habia pasado hace rato.
    [tb_press_btn.sv]
2026-08-28 corregir nombre del dumpfile en tb_r_uart y tb_t_uart
    Escribian el .vcd como dump.vcd en vez de tb_r_uart.vcd/tb_t_uart.vcd,
    asi que make dump (que busca tb_<modulo>.vcd) no los encontraba.
2026-08-28 time_logic.sv: VENTANA_INICIAL no correspondia a los 1.5s del enunciado
    Estaba en 5000, con TICK=100 eso da 50 ticks de ventana inicial en vez
    de los 15 que pide el enunciado (1.5s). La logica de decremento estaba
    bien, ventana_ticks si baja de a 1 por acierto, solo el punto de
    partida estaba mal. Con esto los 3 casos de tb_top que fallaban por la
    duracion de la ventana pasan sin tocar nada mas.
2026-08-28 state.sv: el parpadeo del LED conmutaba al doble de la frecuencia documentada
    El comentario del modulo dice que blink_toggle conmuta cada 2 ticks de
    100ms (400ms, 2.5Hz), pero el always_ff lo hacia cada tick (200ms,
    5Hz). Se agrego blink_div para contar los ticks de a 2 tal como dice
    el comentario original.
2026-08-28 resultados de las simulaciones en el informe, con capturas de vecdump
    Seccion 2 con una subseccion por modulo (r_uart, t_uart, show_mole,
    press_btn, time_logic, hit_counter, fail_counter, state, fsm, top),
    cada una con su forma de onda exportada con make dump + vecdump.
    Seccion 3 con el detalle de los testbenches que habia que arreglar
    para que corrieran, y los dos hallazgos reales que se corrigieron
    (VENTANA_INICIAL y el divisor del parpadeo), mas uno que se documenta
    sin corregir (fin_espera llega un tick de 100ms tarde, no rompe nada
    porque igual cumple el minimo de 2s del enunciado).
2026-08-28 reescribir secciones 2 y 3 del informe con menos relleno
    Los parrafos quedaban todos del mismo tamaño y con demasiados
    parentesis explicativos. Se acorta, se varia el ritmo y se quita todo
    lo que no aportaba.
2026-08-28 Diseño de módulo m09_t_uart
2026-08-28 correción de Análisis e interpretación de resultados
2026-08-28 Actualización de Diseños individuales
2026-08-28 Cambios de diseños finales
